will-zx/smart-greenhouse-dashboard/docs/kontrol.png

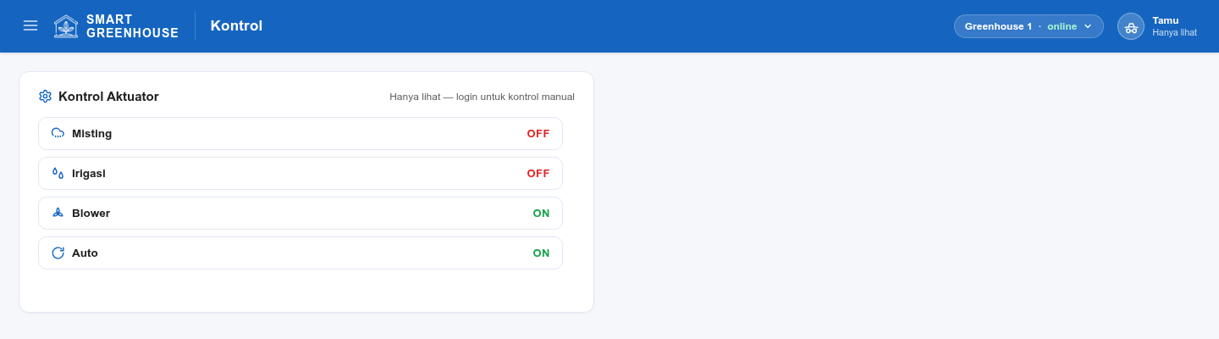
docs/kontrol.png
