will-zx/smart-greenhouse-dashboard/web/greenhouse.png

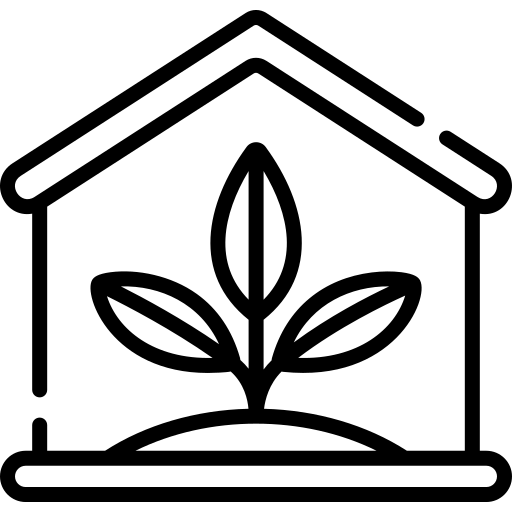
web/greenhouse.png
