will-zx/smart-greenhouse-dashboard/firmware/src/config.h

#ifndef CONFIG_H
#define CONFIG_H

#include "secrets.h"

// WiFi timeout (ms) + jeda percobaan reconnect berikutnya
#define WIFI_TIMEOUT    8000 // ponytail: shorter Wi‑Fi timeout to avoid long AP‑fallback stalls (ceiling: keep >5000 ms for stable reconnect)
#define WIFI_RETRY_MS   10000

// Firebase Realtime Database (Spark gratis, tanpa kartu kredit).
// DEVICE_ID & kredensial akun perangkat ada di secrets.h (satu per unit).
#define FIREBASE_DB_URL       "https://smart-greenhouse-e214c-default-rtdb.asia-southeast1.firebasedatabase.app"
#define LOGS_PATH             "/zones/" DEVICE_ID "/sensor_logs"
#define DB_PUSH_MS            20000
#define DB_POLL_MS            5000

// ID token Firebase berlaku 1 jam; re-login lebih awal agar tidak expired
// di tengah push. 55 menit = 5 menit margin.
#define TOKEN_REFRESH_MS      3300000

// Sensor: SHT31 (I2C, akurasi ±0.2°C / ±2% RH) — share bus dengan LCD.
// Alamat default 0x44 (LCD backpack PCF8574 di 0x27). Modul SHT31 umumnya sudah ada pull-up I2C.
#define SHT31_I2C_ADDR  0x44

// Tiga probe soil (kapasitif) supaya satu zona terwakili beberapa titik tanam.
// WAJIB di ADC1: selama WiFi aktif, ADC2 (GPIO 0,2,4,12-15,25-27) tidak bisa
// dipakai. Pemakaian ADC1 sekarang: 34/33/39 = soil, 35 = TDS, 32 = PUMP_DIST.
// 36 (VP) sengaja dikosongkan sebagai cadangan. 36/39 input-only tanpa
// pull-up - aman untuk keluaran analog modul ini.
#define SOIL_COUNT      3
#define SOIL_PINS       {34, 33, 39}

// I2C bus bersama: SHT31 + LCD 20x4 (backpack PCF8574 0x27; 0x3F = cadangan).
#define I2C_SDA         21
#define I2C_SCL         22
#define LCD_ADDR        0x27
#define LCD_COLS        20
#define LCD_ROWS        4

// Aktuator via modul XY-MOS 400W (umumnya AKTIF-HIGH: HIGH = ON).
// Kalau modul Anda aktif-LOW, set MOSFET_INVERTED 1 (di setActuators).
// Blower: 2 kipas 12x12cm DIPARALEL pada satu output PWM (LEDC).
#define MOSFET_MIST     26
#define BLOWER_PIN      25
#define BLOWER_FREQ     1000   // XY-MOS: spesifikasi PWM 0-20 kHz (25 kHz mati <100%); 1 kHz teruji
#define BLOWER_RES      8
// Duty minimum blower yang benar-benar memutar kipas (hw_test Okt 2026: start
// ~20 %, stop ~13 %). Level fuzzy di bawah ini dibulatkan naik ke nilai ini
// supaya perintah 0 < level < min tidak memerintahkan kipas yang diam.
#define BLOWER_MIN_DUTY 0.20f
#define MOSFET_INVERTED 0

// Pompa irigasi. Prototipe sekarang memakai SATU pompa: DIST (12V) menarik
// air langsung dari penampungan utama ke zona tanam.
// Fertigasi aktif kembali: FILL mengisi ember campuran, FERT menyalakan pompa
// stok A dan B, DIST mengalirkan larutan yang sudah diperiksa ke tanaman.
// Semua via modul XY-MOS/MOSFET (hormati MOSFET_INVERTED).
#define PUMP_FILL          13   // 12V: penampungan utama -> ember campuran
#define PUMP_FERT_A        14   // 5V : pupuk A -> ember
#define PUMP_FERT_B        15   // 5V : pupuk B -> ember
#define PUMP_DIST          32   // 12V: ember campuran -> tanaman

// ==== Durasi tiap fase fertigasi ====
// SEMUA ANGKA DI BAWAH INI BELUM DIUKUR. Masih perkiraan dan ditandai TODO
// supaya tidak tertukar dengan nilai hasil kalibrasi di atas.
// Cara ukur:
//  1) IRRIG_FILL_MS  = volume ember (mL) / debit FILL (31,7 mL/s) x 1000.
//  2) IRRIG_FERT_MS  = dosis yang diminta resep AB Mix / debit FERT (22,2 mL/s).
//  3) IRRIG_SETTLE_MS = jeda sampai pembacaan TDS berhenti bergerak.
// Isi 4,5 L dari ember 5 L: sisakan headroom untuk sisa air/debit pompa yang
// lebih tinggi. Ini bukan pengganti float switch; pasang cutoff overflow untuk
// perlindungan penuh. (4500 mL / 31,7 mL/s x 1000)
#define IRRIG_FILL_MS      141955
#define IRRIG_FERT_MS      1126    // 25 mL stok / 22,2 mL/s x 1000 = ~1,1 detik (TODO: sesuaikan via fase CHECK sampai TDS 800-1000 ppm)
#define IRRIG_SETTLE_MS    30000   // TODO: ukur lapangan - jeda sampai pembacaan TDS berhenti bergerak
// Jeda singkat di fase CHECK supaya pembacaan TDS stabil sebelum dinilai.
// SETTLE sudah memberi 30 detik tanpa pompa, jadi ini hanya jeda tambahan
// satu putaran loop controlTask (2 detik).
#define IRRIG_CHECK_MS      2000
// Batas waktu mutlak tiap fase supaya tidak ada pompa yang berjalan tanpa henti
// bila sensor atau waktunya nyangkut.
#define IRRIG_PHASE_TIMEOUT_MS 180000UL

// ==== Kalibrasi dosis irigasi (TERUKUR 21 Okt 2026) ====
// Debit pompa: gelas ukur + stopwatch, 3x, rata-rata.
//   pompa DIST (dan FILL) = 31,7 mL/s ; pompa FERT = 22,2 mL/s (tidak dipakai
//   lagi selama fertigasi ditunda, dicatat untuk mengaktifkan kembali).
// Cara ukur ulang: letakkan gelas ukur di outlet pompa, nyalakan pompa,
// catat volume setelah 30 s, ulangi 3x, ambil rata-rata -> mL/detik.
#define PUMP_DIST_ML_PER_S   31.7f
#define PUMP_FERT_ML_PER_S   22.2f
// Luas wetted zona: 10 polybag 30x30 cm, 2 baris -> 900 cm2 per tanaman
// (asumsi: permukaan atas polibag = area wetted), total 9000 cm2.
// Cara ukur ulang: hitung luas dasar tiap polybag (pi * d^2 / 4 dengan d =
// diameter polybag) x jumlah polybag.
#define IRRIG_AREA_CM2       9000.0f
// Jumlah siklus irigasi per hari. Dosis per siklus = anggaran harian / nilai
// ini, jeda minimum antar siklus = 24 jam / nilai ini.
// Cara tetapkan: dari kebutuhan harian (ETc x area) dan debit pompa -> bagi
// jadi beberapa dosis kecil supaya tidak ada siram besar sekaligus.
#define IRRIG_CYCLES_PER_DAY 2
// Gate irigasi otomatis: 1 = keputusan fuzzy boleh menyalakan pompa.
// 0 = irigasi otomatis dimatikan (siklus manual tetap bisa); dipakai sebelum
// debit & luas media tersedia. Badge status " IRIGOFF" muncul saat 0.
#define IRRIG_AUTO_ENABLED   1
// Catatan: asumsi efisiensi irigasi 1,0 (volume keluar pompa = volume sampai
// media), jadi TIDAK ada konstanta efisiensi terpisah.

// MicroSD (SPI, pin default VSPI ESP32: SCK 18, MISO 19, MOSI 23, CS 5).
// Backup lokal: seluruh log + antrian saat push Firebase gagal.
#define SD_CS           5
#define SD_BACKLOG_MAX  100
#define SD_BACKLOG_FLUSH_PER_CALL 20
// Tulis ulang seluruh file backlog setiap flush wears kartu SD.
// Push tiap 20s, jadi flush cukup 1x per 5 menit.
#define SD_FLUSH_MS     300000
#define SD_LOG_FLUSH_EVERY  30

// Timing (SHT31 jauh lebih cepat dari DHT22; delay(2000) di loop dipertahankan
// agar push DB & LCD tetap stabil).
#define LCD_INTERVAL    1000

// Baris status LCD (baris 4) di-scroll kalau lebih dari 20 kolom, karena
// controlTask cuma refresh tiap 2 s (terlalu lambat untuk marquee) sehingga
// geseran dikerjakan task kecil sendiri. 350 ms/karakter = ~7 s per putaran
// 20 kolom; ukur dengan mata di jarak baca ~1 m: kalau terasa cepat naikkan,
// kalau lambat turunkan.
#define LCD_SCROLL_MS       350
// Jeda di awal dan akhir teks supaya sempat terbaca sebelum mulai bergeser.
#define LCD_SCROLL_HOLD_MS  1500
// Prioritas di bawah netTask (2) dan controlTask (3): scroll tidak boleh
// menyalip kontrol aktuator. Core 0 (tempat netTask) supaya core 1 tetap
// khusus kontrol.
#define LCD_SCROLL_PRIO     1
#define LCD_SCROLL_STACK    3072   // Wire + LiquidCrystal_I2C + snprintf

// PSU cadangan: hardware-only — ESP32 + aktuator bisa ditenagai powerbank/PSU
// kedua saat listrik mati. Tidak ada kode khusus; dokumentasi di Laporan.

// ==== Blaney-Criddle: kebutuhan air ====
// Sumber: FAO Irrigation and Drainage Paper 24, "Crop Water Requirements",
// bab 1.1 (hal. 3), persamaan ETo = c * [ p * (0.46T + 8) ], dan Table 1
// "Mean Daily Percentage (p) of Annual Daytime Hours for Different Latitudes"
// (hal. 6). Berkas: 02/FAO Crop Water Requirement.pdf.
//
// Cara pakai p DIVALIDASI dari contoh terbuka Kairo pada halaman yang sama:
// lintang 30 derajat Utara bulan Juli, T = 28.5 C -> p = 0.31 -> p(0.46T+8)
// = 6.5 mm/hari. Artinya p dipakai LANGSUNG sebagai pecahan tabel (0.31),
// BUKAN sebagai persen (31) dan BUKAN sebagai hasil tafsir rumus (N/24).
//
// Nilai p tabel FAO-24 berada di kisaran 0.23-0.41 untuk lintang 0-60, dan
// mendekati 0.27 pada lintang rendah. Angka 0.48 yang dipakai sebelumnya
// berasal dari tafsir rumus (N/24) di atas, bukan dari tabel -> ETo melebih
// sekitar 65 persen, dan karena ETc langsung menentukan dosis pompa,
// kelebihan itu ikut terkirim ke tanaman.
//
// Faktor penyesuaian c (bergantung pada RHmin, n/N, dan angin siang) TIDAK
// dipakai di sini (c = 1). FAO-24 meminta metode ini dipakai dengan skeptis
// pada daerah khatulistiwa yang suhunya nyaris konstan, dan Penman-Monteith
// (FAO-56) tetap metode standar. Hasil di sini karena itu dilabeli
// pendekatan, bukan ETo standar.
//
// p per bulan untuk lintang Semarang (6 derajat 58 LS, dibulatkan 7 LS).
// Tabel FAO-24 hanya memuat lintang 0, 5, 10, ... sehingga nilai berikut
// DIHASILKAN DENGAN INTERPOLASI LINIER antara baris 5 dan 10, memakai
// ketentuan catatan kaki tabel: "Southern latitudes: apply 6 month
// difference" (bulan Selatan memakai kolom Utara yang digeser 6 bulan).
// Baris mentah 5 LS dan 10 LS hanya berselisih 0.01, jadi galat
// interpolasinya kecil.
// TODO: PERIKSA ULANG ke Table 1 sebelum dikutip di laporan, karena ini
// hasil interpolasi, bukan bacaan langsung.
static const float SUN_P_MONTH[12] = {
    0.284f, // Januari
    0.280f, // Februari
    0.280f, // Maret
    0.270f, // April
    0.266f, // Mei
    0.266f, // Juni
    0.266f, // Juli
    0.270f, // Agustus
    0.270f, // September
    0.280f, // Oktober
    0.280f, // November
    0.284f  // Desember
};
// Konstanta rumus Blaney-Criddle: ETo = p * (BC_T_COEF * Tmean + BC_T_CONST).
#define BC_T_COEF        0.46f
#define BC_T_CONST       8.0f
// Tmean = rata-rata suhu sliding 3 jam (ember 1 menit). FAO-56 menetapkan
// Penman-Monteith sebagai metode standar; Blaney-Criddle (FAO-24) dikalibrasi
// untuk periode panjang, jadi hasil di sini PENDEKATAN PRAKTIS (bukan ETo
// standar) dan harus diberi label begitu di log maupun telemetri.
#define BC_TMEAN_BUCKET_MS   60000UL   // 1 menit per ember
#define BC_TMEAN_BUCKETS     180      // 180 ember x 1 menit = 3 jam sliding
// Batas atas ETo (mm/hari) supaya nilai ekstrem tidak dipakai.
#define MAX_ET0        12.0

// Kc per fase pertumbuhan. Sumber: Tabel 2.1 proposal ("Nilai koefisien
// tanaman (Kc) pada tanaman cabai merah", data Supriadi et al. [10]):
// Awal 0,40 | Vegetatif 0,75 | Pembungaan 1,10 | Pemuliaan buah 1,00 | Panen 0,90
// Default = fase "Vegetatif" -> perilaku lama (Kc 0,75) tetap berlaku.
#define KC_AWAL           0.40f
#define KC_VEGETATIF      0.75f
#define KC_PEMBUNGAAN     1.10f
#define KC_PEMULIAAN_BUAH 1.00f
#define KC_PANEN          0.90f
#define KC_DEFAULT        KC_VEGETATIF

// Soil Moisture Calibration (modul KAPASITIF, inverted ADC: kering=tinggi, basah=rendah).
// Urutan array = urutan SOIL_PINS: {34, 33, 39}.
// Kalibrasi PER PROBE: dua modul model sama bisa beda ratusan count, jadi satu
// angka untuk semuanya membuat persentase salah. Cara ukur (~10 menit):
//   1) probe di udara kering, tunggu ~3 menit, baca "raw" pada baris Soil:n
//   2) probe terendam penuh di air, baca lagi
//   3) isi SOIL_DRY_CAL = bacaan kering, SOIL_WET_CAL = bacaan basah
//      (kering selalu > basah karena ADC terbalik; kalau tidak, kabel tertukar)
// ponytail: angka awal masih asumsi v1.2 (2644/1200); ukur ulang per probe.
#define SOIL_DRY_CAL    {2644, 2644, 2644}
#define SOIL_WET_CAL    {1200, 1200, 1200}
// Toleransi raw ADC di luar titik kalibrasi. Probe dicabut -> ADC mengambang
// (0 atau 4095) -> di luar rentang ini -> ditandai tidak valid (bukan 100 %
// basah / 0 % kering palsu). Angka ini hanya "jaring pengaman", bukan kalibrasi.
#define SOIL_RAW_TOL 300
// Sampel per kanal. Sampel pertama DIBUANG (bukan dirata-rata) karena ADC
// ESP32 masih membawa sisa muatan kanal sebelumnya; kapasitif berimpedansi
// tinggi sehingga satu bacaan pertama sering meleset jauh.
#define SOIL_SAMPLES   4
// Jeda antar kanal. Kalau angka tiga probe terlihat saling "menular" (mis. probe
// 33 mengikuti nilai 34), naikkan ini; kelipatan 10 ms murah di loop 2 s.
#define SOIL_SETTLE_MS 10

// TDS Meter v1.0 (analog, klon DFRobot SEN0244) di ember campuran irigasi.
// Output ~0..2.3V. GPIO35 = ADC input-only tanpa pull-up. Kompensasi suhu
// memakai suhu SHT31. Kalibrasi: TDS_CAL_K (set dengan larutan standar).
// CATATAN: TDS dipakai sebagai PEMERIKSA setelah larutan homogen, bukan
// pengendali dosis. Dosis stok A/B berjalan selama IRRIG_FERT_MS (lingkaran
// terbuka) menurut debit pompa yang sudah terukur, sehingga konsentrasi
// diharapkan jatuh di dalam rentang. TDS memverifikasi dugaan itu.
//
// PERILAKU SAAT DI LUAR RENTANG: kalau TDS TERBACA sah dan di luar rentang,
// DIST DITAHAN (siklus dibatalkan, anggaran harian dikembalikan) karena kimia
// larutannya jelas salah. Kalau probe TIDAK terbaca (tdsValid=false), air
// tetap dialirkan dengan peringatan - tanpa probe tanaman tidak akan pernah
// disiram. Lihat fase IRRIG_CHECK di irrigation.cpp.
#define TDS_PIN         35
#define TDS_ADC_MAX     4095.0
#define TDS_REF_VOLT    3.3
#define TDS_TARGET_PPM  1000.0  // konsentrasi larutan akhir (air penampungan ~400 ppm)
#define TDS_CAL_K       1.0
// Rentang penerimaan larutan sebelum distribusi.
// TODO: perkiraan belaka. Tetapkan dari resep AB Mix yang benar-benar dipakai:
//   ppm_target = dosis stok (mL) / volume ember (mL) x konsentrasi stok (ppm)
// Lalu ukur dengan larutan standar dan sesuaikan TDS_CAL_K.
#define TDS_MIN_PPM     800.0f
#define TDS_MAX_PPM    1200.0f
// Rentang raw ADC yang dianggap sah (probe terendam, bukan mengambang / dicabut)
// dan rentang ppm. Di luar itu TDS ditandai tidak valid -> dosis pupuk tidak
// dihitung dari angka garbage.
#define TDS_RAW_MIN     200
#define TDS_RAW_MAX     3000
#define TDS_PPM_MIN     50.0f
#define TDS_PPM_MAX     5000.0f
// Ambang stabilitas antar 8 sampel TDS. Pin GPIO35 (ADC input-only, tanpa
// pull-up/pull-down) melayang saat probe dicabut -> nilai tengah tak stabil
// yang lolos cek rentang [TDS_RAW_MIN, TDS_RAW_MAX] dan menghasilkan PPM palsu.
// Kalau spread terlalu besar, angka dianggap tidak andal -> valid = false.
#define TDS_FLOAT_SPREAD 300.0f

// Filter EMA (Exponential Moving Average): y[n] = alpha*x[n] + (1-alpha)*y[n-1].
// alpha kecil = lebih halus tapi lebih lambat. Dipakai untuk suhu & kelembaban
// (input VPD) serta soil, agar VPD dan keputusan irigasi tidak bergetar.
// Alfa di sini PER-SAMPEL, bukan per-detik: konstanta waktunya t = dt/alfa.
// Loop controlTask 2000 ms dengan alfa 0.2 -> t = 10 s (63% perubahan dalam
// 10 s). Kalau periode loop diubah, alfa harus diskalakan ulang: alfa = dt/(t+dt).
#define EMA_ALPHA_TEMP  0.2f
#define EMA_ALPHA_HUM   0.2f
#define EMA_ALPHA_SOIL  0.2f
// TDS paling bising (pompa fert berdenyut 2 s on / 1 s off, jadi dua iterasi
// berurutan bisa menangkap kondisi adukan berbeda). Difilter lebih cepat dari
// suhu/kelembapan supaya gate target TDS tidak bereaksi pada satu sampel.
#define EMA_ALPHA_TDS   0.3f

// Kontrol VPD berbasis setpoint fase (di-set admin dari dashboard). Setpoint
// ini KOREKSI terhadap keluaran fuzzy, bukan pengganti: fuzzy tetap menentukan
// apa yang dijalankan, setpoint hanya mendorong satu arah.
// VPD > target+BAND -> tambah/pertahankan misting (blower tetap sesuai fuzzy).
// VPD < target-BAND -> dorong blower proporsional (misting tetap sesuai fuzzy).
// Di dalam band -> fuzzy menentukan sepenuhnya.
#define VPD_BAND_KPA    0.2f
// Duty maksimum yang boleh ditambahkan setpoint ke blower. Setpoint tidak
// pernah menaikkan blower ke penuh mendadak; duty penuh hanya bila fuzzy
// juga memintanya.
#define VPD_BOOST_MAX   0.6f
// Rentang VPD target yang diterima dari dashboard (kPa). Di luar ini perintah
// ditolak di sisi device (VPD wajar hortikultura: 0,3-2,5 kPa).
#define VPD_TARGET_MIN  0.3f
#define VPD_TARGET_MAX  2.5f


// Setelan fase default (dipakai bila NVS masih kosong). Admin dapat mengubah
// nama fase, VPD target, dan durasi dari dashboard; tersimpan di NVS.
#define PHASE_DEFAULT_VPD       1.0f       // kPa
#define PHASE_DEFAULT_NAME      "Vegetatif"
#define PHASE_DEFAULT_DURATION  0u         // detik; 0 = tanpa batas
#define NVS_NAMESPACE           "smartgh"

// Batas durasi override manual (ms). Setelah lewat, aktuator yang di-override
// otomatis kembali ke kendali fuzzy — misting tidak boleh menyala semalaman.
#define MANUAL_MAX_MS           600000UL   // 10 menit

// Timeout Task WDT (detik) + inisialisasi eksplisit (lihat RumahHijau.ino).
#define WDT_TIMEOUT_S           5

// Cooldown perintah restart (ms) supaya reboot berulang tidak memutus
// siklus irigasi.
#define RESTART_COOLDOWN_MS     60000UL

// Durasi fase maksimum (detik) = 365 hari, biar tidak overflow uint32.
#define PHASE_MAX_DURATION_SEC  31536000UL

#endif
