will-zx/smart-greenhouse-dashboard/(commit log)

2026-09-09 Inisialisasi project: firmware ESP32 + web dashboard Firebase
2026-09-13 UI: toggle switch aktuator & Auto, ikon rumah, ekspos manual_mode ke RTDB
2026-09-13 Auth: sesi per-tab (SESSION) — tutup tab = login ulang
2026-09-30 REV.1 + multi-zone: SHT31/MOSFET/MicroSD, hapus Telegram, path zones/{id}
    Hardware & kontrol:
    - Sensor DHT22 -> SHT31 (I2C 0x44, share bus dengan OLED)
    - Relay active-LOW -> modul MOSFET 15A/400W aktif-HIGH (knob MOSFET_INVERTED)
    - Blower on/off -> PWM LEDC 25kHz, duty = fuzzy.blowerLevel
    - Telegram bot dihapus (kanal kontrol hanya dashboard); alert suhu ekstrem ke serial
    - sd_logger: CSV lokal tiap bacaan + antrean backlog saat push RTDB gagal
    - Irigasi jadi single source of truth di irrigation.shouldIrrigate
    - Fuzzy pakai VPD (cabai): vpdHigh dorong misting, vpdLow suppress mist + blower
    Multi-zone (greenhouse-in-greenhouse):
    - DEVICE_ID pindah ke secrets.h (satu per unit, tidak di-commit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
2026-09-30 Dashboard: multi-zone, label greenhouse, penyembunyian kontrol untuk viewer
    - ZONES[] di config.js ganti DEVICE_ID; satu dashboard untuk banyak unit
    - Selector zona di header + device id aktif; fetch per zona terpilih
    - Badge online per zona dari umur log (>60s = 'diam N menit')
    - Label greenhouse: labels/{DEVICE_ID} di RTDB, admin ubah lewat tombol pensil
    - applyRole(): sembunyikan card kontrol + tombol label, badge 'Mode lihat' untuk non-admin
    - app.js?v=9 -> ?v=11 (cache-buster Cloudflare)
2026-09-30 .gitignore: plugin OpenCode lokal + backup rules RTDB
    .rules_rtdb.bak = jaring pengaman sebelum publish rules, jangan masuk repo
    (plugin .opencode/ sudah di-version-control, tapi plugins/ state per mesin)
2026-09-30 Keluarkan AGENTS.md & opencode.json dari repo
    --cached: file tetap ada di disk, hanya lepas dari index.
    AGENTS.md = instrucciones lokal tim; opencode.json = state per mesin.
    .gitignore tetap di repo supaya proteksi secrets.h ikut ke clone baru.
2026-10-08 Irigasi 4 pompa + sensor TDS: siklus FILL-FERT-DIST, keputusan irigasi pindah ke fuzzy Mamdani (soil x ETc)
2026-10-11 Firmware RTOS 2-task: controlTask (core 1) + netTask (core 0), snapshot bermutex
    - I/O jaringan (TLS handshake, WiFi join s/d 15s) tidak lagi menahan jalur
    aktuator; pulse pompa FERT 2s/1s tidak korup saat push gagal/reconnect.
    - controlTask: sensor -> VPD/ETc -> fuzzy -> override -> aktuator -> state
    machine irigasi -> LCD -> log SD -> publish snapshot (periode 2s).
    - netTask: WiFi join/reconnect, NTP, token, push 20s, poll perintah 5s,
    backlog MicroSD. loop() tinggal idle.
    - Mutex: state manual (control.cpp), akses SD dua task (sd_logger.cpp);
    sdFlushBacklog lepas kunci saat HTTP supaya tidak menahan controlTask.
2026-10-11 Dashboard: switch/Auto sinkron dari perangkat + umpan balik seketika saat klik
    - fetchDataLogs() tidak pernah memanggil updateActuatorStates(): posisi switch
    dan toggle Auto tak pernah tersinkron di mode live (state hanya disimpulkan
    dari entri sensor_logs terbaru; tidak ada node state di RTDB).
    - applyLocalCommand(): perintah sukses langsung memperbarui tampilan, jadi Auto
    mati begitu switch aktuator diklik, tanpa menunggu push 20 s (DRY: dipakai
    jalur live dan demo).
    - optimistic (35 s = poll 5 s + push 20 s + fetch 10 s): menahan tampilan sampai
    log yang mencerminkan perintah tiba, supaya switch tidak balik sendiri.
    - cache-buster app.js?v=12.
2026-10-11 Firmware: filter EMA sensor + kontrol VPD setpoint fase
    - filter.{h,cpp}: EMA (alpha dari config.h) untuk suhu, RH (input VPD), soil
    - phase.{h,cpp}: VPD target + nama fase + durasi, disimpan di NVS
    - kontrol override: VPD > target+band -> MISTING, < target-band -> BLOWER
    - pollCommands: set_vpd / set_fase / set_durasi / fase_reset
    - pushSensorLog: telemetri fase (vpd_target, fase_elapsed_s, fase_sisa_s)
2026-10-12 Firmware: fail-safe sensor mati + task WDT untuk controlTask
    Dua celah yang bisa menyisakan pompa/misting nyala tanpa kendali:
    1. Nilai fuzzy beku saat sensor invalid. `fuzzyOut` hanya ditulis di dalam
    `if (sensorData.valid)`, tapi dibaca tanpa syarat di bawahnya. SHT31
    putus -> mist/blower/irigasi tetap memakai keputusan iterasi valid
    terakhir, selamanya, dan misting/irigasi tidak punya timeout sendiri.
    Sekarang semua aktuator dipatikan saat `!valid` (override manual ikut)
    dan siklus irigasi berjalan dibatalkan via irrigationAbort().
    Status jadi "Sensor Error" (bukan "Normal" basi) supaya operator dan
    pill dashboard ikut tahu regulate sudah berhenti.
    2. controlTask bi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
2026-10-12 Dashboard: ikon header pakai greenhouse.png
    SVG inline di h1 diganti asset greenhouse.png (512x512, garis hitam
    dengan alpha transparan tanpa latar putih).
    Warna lewat CSS mask, bukan filter invert: mask memberi #90caf9 yang sama
    dengan ikon svg lama (lewat background-color), sedangkan invert() hanya
    menghasilkan putih dan akan terlihat berbeda dari ikon lain di header.
    Aturan .header h1 svg ikut dihapus karena h1 tidak lagi memuat svg.
    Verified: semua piksel di luar garis punya alpha 0 dan tidak ada piksel
    putih opaque, jadi tidak muncul kotak putih pada header biru tua._aturan
    svg lain (.badge, .card-head, .ctrl, .metric, .refresh) tidak tersentuh.
2026-10-12 Dashboard: fix ikon header (elemen kosong, 28px, putih) + cache-busting
    Ikon tetap hitam meski mask sudah aktif. Penyebabnya: mask berlaku ke
    seluruh rendering elemen, dan konten <img> bersifat opaque sehingga
    menutupi background-color di belakangnya. Warnanya tidak pernah terlihat.
    Mask hanya bisa mengecat elemen KOSONG -> <img> diganti <span>.
    Ukuran 22 -> 28 px (garis PNG ~2% dari 512 px, di 22 px只剩 1 px).
    Warna #90caf9 -> #fff, mengikuti teks header.
    style.css dimuat tanpa versi (?v=) sehingga browser menyajikan CSS lama
    dari cache dan perbaikan tidak terlihat. Sekarang ?v=13,_seperti app.js?v=12.
    aria-hidden="true" pada span: ikon dekoratif, tanpa itu screen reader
    membacakan nam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
2026-10-12 Dashboard: ET0 jadi subskrip di label metrik (flex mengabaikan vertical-align)
2026-10-12 Dashboard: bungkus ET0 dalam span agar subskrip di label metrik benar
2026-10-12 Dashboard: hapus tooltip email di avatar, email tetap di menu akun
2026-10-12 Dashboard: migrasi layout admin (sidebar + topbar) sesuai referensi; satu skema warna; burger toggle sidebar di desktop & drawer di mobile
2026-10-13 Dashboard: tombol pensil rename per unit, hover user chip tanpa tabrakan teks, sinkron switch/teks ON-OFF, Refresh berputar, tag nama greenhouse di grafik
2026-10-13 Dashboard: perbaiki nama unit yang tak terlihat (warna putih di kartu putih), tag + Refresh juga di halaman Log
2026-10-13 Dashboard: gabungkan pemilih greenhouse + status koneksi, ganti prompt() dengan input inline, perbaiki tidak bisa ganti unit di handphone
2026-10-13 Dashboard: status unit tetap terlihat di ponsel, ikon ikut mewarnai status, kartu kontrol ikut konten
2026-10-13 README: ganti diagram alur ASCII dengan mermaid (baca & tulis via RTDB, task ESP32 terpisah)
2026-10-13 Firmware: arsipkan firmware_old, hapus kode mati, satukan setter kontrol
    Audit over-engineering repo (laporannya di /sdcard/ponytail-audit.txt).
    11 dari 13 temuan diterapkan; item 2 (modul fase) dan 3 (antrean backlog
    SD) ditunda karena butuh keputusan pemilik perangkat.
    - hapus firmware_old/ (25 file, -1046): arsip pra-FreeRTOS yang sudah ada
    di git history (c8be90e)
    - control: controlSetMist/Irig/Blower -> controlSet(bit, on) dengan
    bitmask uint8_t; 3 setter identik jadi satu fungsi
    - fuzzy: 3 blok loop identik -> helper evalRules() + tipe Rule
    - vpd.h/.cpp -> calcVpd() statis di RumahHijau.ino
    - hapus kode mati: emaReset(), phaseElapsed(), FuzzyOutput::irigasiLevel
    Verifikasi: fuzzy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
2026-10-13 Dashboard: hapus halaman Kontrol & sidebar, kontrol menyatu di Beranda
    Satu halaman dengan dua blok: 6 metrik (2 kolom x 3 baris) di kiri,
    kartu Kontrol Aktuator di sebelahnya, grafik tren penuh di bawah.
    Di ponsel semuanya satu kolom: metrik -> kontrol -> grafik.
    - hapus <section id="view-kontrol">; 4 sakelar pindah ke kartu kontrol
    (id state-*/sw-* dipertahankan, updateActuatorStates & onSwitch
    tidak berubah)
    - hapus sidebar + burger + drawer; navigasi cukup tombol Log Sensor
    di topbar yang toggle Beranda <-> Log Sensor (state baru: currentView)
    - topbar: brand pindah ke kiri, teks posisi halaman dihapus
    - kartu grafik: judul + tag unit + Refresh satu baris di kanan,
    keterangan "D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
2026-10-13 Dashboard: kembalikan teks branding di ponsel, buang garis pemisah brand
    Aturan `.brand-text { display: none }` di bawah 700px adalah warisan waktu
    brand masih di sidebar (248px). Setelah sidebar dihapus brand tinggal di
    topbar yang sempit, jadi teksnya tidak lagi boleh disembunyikan - yang
    tersisa cuma ikon, garis pemisah yang menggantung, dan ruang kosong.
    - <=700px: teks brand kembali (11px, dua baris seperti desain aslinya),
    ikon 28 -> 24px, gap 10 -> 8px
    - yang boleh dipotong bukan branding tapi status unit: .zone-status
    flex 0 0 auto -> 0 1 auto + min-width:0 (juga di .topbar-actions dan
    .zone-btn), jadi pill "diam 2806 mnt" yang menyusut lebih dulu di
    layar sempit
    - .brand: h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
2026-10-13 Docs: refresh screenshot dashboard & log sensor sesuai layout baru
    - dashboard.png: metrik 2x3 di kiri, kartu Kontrol Aktuator (ikon gear)
    di sebelahnya dengan tepi bawah rata, grafik tren penuh di bawah;
    keterangan "Data terakhir ..." ada di bawah grafik, bukan di header
    - log-sensor.png: tombol topbar jadi "Beranda" (state terbalik saat Log
    terbuka) dan kartu log tanpa teks posisi halaman
    - kembalikan referensi docs/log-sensor.png di README; file itu sudah ada
    sejak commit f39fb64 tapi rujukan gambarnya hilang, jadi tidak pernah
    tampil di README
    Catatan (bukan bagian commit ini): urutan waktu di tabel log dan sumbu X
    grafik masih urut push-ID Firebase, bukan field ts - tampak di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
2026-10-14 Dashboard: perbaiki pembacaan log, rapikan durasi & warna status, revisi kartu grafik
    - apiRead(): token ditempel dengan '&' bila path sudah punya query string.
    Sebelumnya selalu '?auth=', jadi limitToLast jadi "20?auth=..." dan RTDB
    membalas 400 "limitToLast must be an integer". Tidak terdeteksi karena tamu
    tanpa token tidak pernah terpengaruh.
    - Durasi umur data dalam bahasa sehari-hari (detik/menit/jam/hari) lewat satu
    fungsi humanAge(); pakai floor, bukan round, supaya 23 jam 59 menit tidak
    melebar jadi "24 jam". Dipakai di bawah grafik dan di pill greenhouse.
    - Pill greenhouse: tidak menampilkan nama unit lagi, hanya kapan data terakhir
    masuk. Status ditandai warna isian (hi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
2026-10-14 Docs: segarkan screenshot & keterangan tampilan sesuai dashboard terbaru
    Screenshot diambil ulang dari tampilan tamu (tanpa login) pada lebar 1440 px
    dan 390 px. Tiga bagian README yang sudah tidak sesuai dengan kode:
    - status di tombol greenhouse kini warna isian (hijau = segar, kuning = basi
    kurang dari sehari, merah = basi lebih dari sehari atau gagal dibaca) dan isian
    tombolnyaumur data terakhir, bukan nama unit
    - nama greenhouse menyambung di judul kartu grafik, bukan chip terpisah
    - tabel log punya kolom waktu yang menempel di kiri saat digeser di ponsel
    Ditambah screenshot tampilan ponsel, karena tata letak satu kolomnya kini
    dijelaskan di README tanpa bukti gambar.
2026-10-14 Git: abaikan web/config.js (berisi API key & email admin)
    Baruatarsilan-box: .gitignore hanya berlaku untuk file yang belum pernah
    di-commit, jadi entri ini belum mengubah apa pun - web/config.js masih
    terlacak. Penghapusan dari indeks (git rm --cached) sengaja tidak dilakukan
    karena dashboard berjalan di worker dan mungkin menarik file dari repo.
    Yang benar-benar sensitif - firmware/src/secrets.h berisi password akun
    perangkat - memang tidak pernah masuk history sama sekali.
2026-10-14 Dashboard: urutkan log & grafik berdasarkan waktu, kontras pill hijau
    - Log sensor diurutkan berdasarkan field ts, bukan kunci push-ID RTDB.
    Kunci urut saat apa yang ditulis, tapi record lama yang diputar ulang
    dari backlog MicroSD dapat kunci baru - kunci jadi tidak sama dengan
    waktu. Akibatnya kolom waktu di tabel tidak urut (22.27.15 -> 22.26.45
    -> 22.27.35 -> 18.36.08) dan sumbu X grafik melompat. Sekarang
    Object.values + sort ts, satu baris lebih pendek dari versi lama.
    - Pill hijau #3f9c44 -> #2e7d32: rasio kontras teks putih 3.47:1 -> 5.13:1,
    melewati ambang WCAG AA 4.5:1 untuk teks kecil. Merah 4.75:1 dan kuning
    12.84:1 sudah memenuhi.
    - Koreksi komentar di blok 700px y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
2026-10-14 Firmware: filter EMA untuk TDS, koreksi cakupan filter soil
    TDS adalah kanal paling bising dan satu-satunya yang tidak difilter: yang
    ada cuma rata-rata 8 sampel dalam 80 ms di readTDS(), itu meredam noise ADC
    dalam satu iterasi saja. Pompa fert berdenyut 2 s on / 1 s off sementara
    loop controlTask membaca tiap 2 s, jadi dua iterasi berurutan menangkap
    kondisi adukan yang berbeda - terlihat di log TDS dashboard yang melompat
    0 -> 117 -> 23 -> 34 -> 0 -> 6 -> 144 ppm.
    - EmaFilter keempat untuk TDS (alfa 0.3, tau ~6.7 s). Gate target di
    irrigation.cpp memakai nilai terfilter ini sekarang.
    - irrigationPhase() sebagai accessor, dipakai me-reset filter TDS tiap
    siklus masuk fase FERT. Empiri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
2026-10-18 Firmware: bulatkan duty blower di bawah 20% ke duty minimum kipas
    Kipas hasil uji hw_test baru berputar pada duty ~20% dan berhenti di ~13%,
    sehingga level fuzzy 0 < level < 0,20 memerintahkan kipas yang diam. Level
    kini dinaikkan ke BLOWER_MIN_DUTY (config.h) sebelum dikirim ke LEDC, lalu
    dicetak sekali lewat Serial. fuzzy.cpp tidak diubah supaya lapisan
    keputusan tetap murni.
2026-10-18 Tools: simulasi logika fuzzy Octave + model .fis
    firmware/tools/fuzzy_sim.m adalah replika fuzzy.cpp (13 membership, 3 tabel
    rule, evalRules) dengan tabel kasus acuan yang di-assert, sehingga perubahan
    tabel rule di firmware langsung ketahuan. Menghasilkan grafik (butuh gnuplot,
    diabaikan lewat .gitignore) dan fuzzy_rules.fis untuk dibuka di MATLAB
    fuzzyLogicDesigner. Jalankan dari akar repo:
    octave --no-gui --eval "addpath('firmware/tools'); fuzzy_sim"
2026-10-19 Firmware: kirim keluaran fuzzy aktuator ke RTDB
    Tambahkan blower_level, misting, dan irigasi ke payload sensor_logs.
    Selama ini dashboard harus menguraikan string status_sistem untuk tahu
    aktuator mana yang hidup — rapuh, karena bergantung pada format teks.
2026-10-19 Web: migrasi dashboard ke Vue 3 + Vite + Tailwind
    Ganti file statis (index.html + app.js + style.css, 1533 baris) dengan
    proyek Vue 3 + Vite 8 + Tailwind 4. Semua 80 pemanggilan DOM manual
    (getElementById/innerHTML/classList) dan 5 handler inline hilang; logika
    sensor dipindah apa adanya ke satu reactive() di src/store.js.
    Perubahan:
    - 9 komponen .vue, CSS 533 -> 53 baris (@theme palet)
    - config.js pindah ke public/ (Vite menyalin apa adanya ke dist/)
    - ikon brand greenhouse.png jadi CSS mask, kembali seperti semula
    - layout metrik 2x3 + kolom kontrol proporsional 46% (seperti desain lama)
    Bug yang tertangkap saat migrasi:
    - popup unit kosong: const di config.js masuk global LEXICAL, bukan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
2026-10-19 Web: tambah wrangler.jsonc untuk Cloudflare Workers static assets
    Project ini Workers dengan static assets, bukan Pages klasik — dashboard
    menampilkan "Triggers cannot be added to a Worker that only has static
    assets" dan TIDAK punya field "build output directory". Folder hasil
    build ditentukan di file config, jadi wrangler.jsonc wajib ada;
    tanpa itu `wrangler deploy` tidak tahu mana yang harus di-upload.
    wrangler dijadikan devDependency karena deploy command memanggil
    `npx wrangler deploy`. Dry-run terverifikasi: 6 file terbaca dari dist/.
2026-10-19 Web: shorten Worker subdomain
    smart-greenhouse-dashboard.capstone-26.workers.dev (54 char) ->
    versi yang lebih pendek. Nama Worker di wrangler.jsonc WAJIB sama
    persis dengan yang ada di dashboard; kalau beda, `wrangler deploy`
    membuat Worker baru dan production tetap menyajikan versi lama.
2026-10-19 README: catat URL produksi yang aktif
    Dashboard live di smartgh.capstone-26.workers.dev (Cloudflare Workers
    dengan static assets). README sebelumnya tidak punya tautan sama sekali
    ke dashboard yang sedang jalan.
2026-10-21 Firmware: overhaul override manual, WDT, setpoint VPD, dan validasi sensor
    Bug P0 yang diperbaiki:
    - Override manual jadi TRIS-TATA per aktuator (-1 ikut fuzzy, 0 paksa mati,
    1 paksa nyala). Dulu satu bitmask mengatur SEMUA aktuator, jadi mematikan
    satu sakelar mematikan seluruh aktuator dan tidak ada jalan kembali
    selain Auto. Sekarang mematikan sakelar = aktuator itu kembali ke fuzzy;
    Auto (controlRelease) mengembalikan semua.
    - Task WDT di-init eksplisit di setup() (timeout 5 s, panic). Framework
    arduino-esp32 2.0.17 (ESP-IDF 4.4) tidak pernah memanggil
    esp_task_wdt_init() sendiri (CONFIG_ESP_TASK_WDT_INIT tidak ada di
    sdkconfig), jadi subscribe controlTask gagal diam-diam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
2026-10-21 Firmware: perbaiki edge-trigger irigasi, ETc Blaney-Criddle, status override
    G-1 (P0) Irigasi mati permanen setelah sensor error singkat. prevTrigger
    tadinya static di dalam irrigationUpdate() dan tidak pernah di-reset;
    irrigationAbort() (dipanggil dari luar) tidak melewatinya, jadi permintaan
    yang masih TRUE setelah pemulihan tidak pernah lagi memicu siklus.
    Sekarang prevTrigger jadi state modul, di-reset saat abort, dan ada flag
    resumePending supaya permintaan yang masih aktif langsung memulai siklus
    baru (log "siklus DIPULIHKAN"). Edge-detect tetap: satu permintaan = satu
    siklus. Log baru: siklus dimulai / dibatalkan / dipulihkan.
    G-2 (P0) Status override per aktuator dikirim ke RTDB: mi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
2026-10-21 Web: badge IRRIGOFF, koreksi komentar perintah, README sesuai UI sekarang
    - Badge IRRIGOFF di tabel log (warna peringatan, bukan merah) + banner amber di
    kartu Kontrol: irigasi otomatis sengaja dimatikan perangkat sampai debit
    pompa dikalibrasi, perintah manual tetap jalan. Banner juga tampil untuk tamu.
    - Koreksi komentar blok "perintah RTDB": bentuk lama (POST {action,value} ke
    commands/{DEVICE_ID}) sebenarnya juga terbaca firmware, karena POST di REST
    Firebase setara push() sehingga objek itu berakhir sebagai anak ber-push-ID.
    Entri tetap ditulis sebagai anak dengan kunci eksplisit supaya urutannya
    jelas; kode pengiriman tidak diubah.
    - parseOverride sekarang mengenali string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
2026-10-21 Docs: perbarui screenshot dashboard ke UI Vue yang sedang produksi
    Tiga screenshot diambil ulang dari produksi (https://smartgh.capstone-26.workers.dev/)
    dalam mode Tamu, setelah deploy bundle baru:
    - docs/dashboard.png (1440x1083) - Beranda: metrik (ETc), kartu Kontrol Aktuator
    tanpa sakelar admin, panel Fase & Setpoint VPD, grafik tren.
    - docs/log-sensor.png (1440x1200) - Log Sensor: 20 baris terbaru, kolom ETc,
    tombol Export CSV, catatan retensi.
    - docs/mobile.png (390x1372, skala 2) - tampilan ponsel.
    Data di RTDB terakhir berasal dari perangkat yang push 11 Okt, jadi pill kesegaran
    dan keterangan "Data terakhir ..." sengaja masih merah/basi.
2026-10-21 Docs: ukuran screenshot dashboard sesuai permintaan (1440x900, 390x844 @2x)
    dalam mode Tamu, ukuran persis seperti dokumenasi sebelumnya:
    - docs/dashboard.png (1440x900) - Beranda: metrik (ETc), Kontrol Aktuator tanpa
    sakelar admin, Panel Fase & Setpoint VPD, grafik tren dengan garis terisi.
    - docs/log-sensor.png (1440x900) - Log Sensor: 20 baris terbaru, kolom ETc,
    tombol Export CSV.
    - docs/mobile.png (390x844, skala 2) - tampilan ponsel.
    Data RTDB terakhir berasal dari perangkat yang push 11 Okt, jadi pill kesegaran
    dan keterangan "Data terakhir ..." masih merah/basi - memang kondisi nyata.
    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
2026-10-21 Firmware: irigasi satu pompa DIST dengan dosis dari ETc (Blaney-Criddle)
    Prototipe sekarang memakai SATU pompa (DIST) yang menarik air langsung dari
    penampungan utama; fase FILL (isi ember) dan FERT (dosis pupuk) dibuang.
    PUMP_FILL/PUMP_FERT_A/PUMP_FERT_B tetap ada di config.h dan tetap dipaksa
    LOW di initActuators(): firmware tidak pernah memanggilnya.
    Irigasi (irrigation.cpp)
    - State machine IDLE -> DIST -> IDLE; penggerak pompa cuma setDist().
    - Dosis air per siklus dihitung dari ETc yang sudah ada (Tmean sliding 3 jam
    x Kc fase):
    anggaran_harian_ml = ETc * IRRIG_AREA_CM2 * 0,1
    dosis_ml = anggaran_harian_ml / IRRIG_CYCLES_PER_DAY
    durasi_pompa_ms = dosis_ml / PU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
2026-10-21 Web: rapikan jarak kartu grafik, longgarkan CSP untuk koneksi Firebase
    Jarak antara kartu "Fase & Setpoint VPD" dan "Grafik Tren Sensor" kelihatan
    jauh lebih besar daripada jarak antar kartu lain, di desktop maupun ponsel.
    Penyebabnya TrendChart.vue punya mt-5 di root-nya, sementara section di
    App.vue sudah memberi gap-5 untuk semua anak. mt-5 itu sisa layout lama
    saat grafik menempel langsung di baris metrik; setelah Panel Fase
    disisipkan, margin itu menumpuk jadi jarak dobel hanya di kartu ini.
    TrendChart satu-satunya komponen yang punya margin di root-nya - dihapus
    supaya ritme jarak seragam di semua tampilan.
    CSP: connect-src ditambah www.gstatic.com, *.nstatic.com, dan
    wss://*.firebase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
2026-10-21 Docs: perbarui screenshot dashboard setelah perbaikan jarak kartu
    Layout berubah karena mt-5 pada kartu Grafik Tren Sensor dihapus, jadi
    capture lama tidak lagi mencerminkan tampilan produksi. Ukuran tetap sama
    seperti sebelumnya: 1440x900 untuk desktop dan 390x844 @2x untuk ponsel.
    Screenshot Log Sensor tidak berubah karena tampilan log tidak terpengaruh.
2026-10-25 Firmware: perbaiki Tmean selalu NaN (ETc 0, irigasi tidak pernah jalan)
    Ditemukan saat uji di device setelah flash: serial menampilkan
    "Tmean:nan ETc:0.0mm" terus-menerus, padahal SHT31 terbaca valid.
    Akar masalah: tmeanBucket[] adalah array static sehingga terisi 0,0, bukan
    NaN, sedangkan sentinel "ember kosong" di irrigationFeedTemp() adalah NaN.
    Akibatnya isnan() tidak pernah true -> tmeanValid tidak pernah bertambah ->
    irrigationTmean() selalu mengembalikan NaN -> calculateEtc() = 0 -> dosis 0
    dan irigasi tidak pernah jalan. Bug masuk bersama Tmean sliding window
    (commit 625b13d) dan tidak tertangkap simulasi karena simulasi tidak
    mereplikasi jendela Tmean.
    Perbaikan: isi array dengan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
2026-10-25 Firmware: jangan eksekusi ulang perintah RTDB yang sama
    Ditemukan setelah device tersambung ke RTDB: satu perintah dieksekusi ulang
    tiap poll 5 s (blower dipaksa nyala terus, irigasi berulang). Penyebabnya
    aturan RTDB: /commands/$zone hanya boleh DITULIS admin, device hanya boleh
    baca, jadi DELETE dari device selalu ditolak 401 dan entri tidak pernah
    hilang. Node commands/{DEVICE_ID} sudah berisi 65 entri lama.
    Perbaikan (tidak mengubah aturan RTDB):
    - Penanda perintah terakhir yang sudah dieksekusi disimpan di NVS
    (last_cmd). Push-ID Firebase terurut leksikografis, jadi key <= last_cmd
    dianggap sudah dijalankan dan dilewati. Bertahan walau reboot.
    - Entri yang bukan objek perintah dile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
2026-10-25 Web: grafik air (VPD + kebutuhan/pemakaian) dan rentang 6 jam/24 jam
    - TrendChart: prop mode ('iklim' default, perilaku lama; 'air' memuat VPD
    kiri 0-4 kPa, target VPD putus-putus, kebutuhan harian dari ETc pada
    sumbu kanan mL, dan volume terpakai hari ini sebagai garis stepped).
    Tooltip air menyebut ETc penyusun anggaran dan kata "hari ini", karena
    irigasi_terpakai_ml reset tiap 00:00 WIB.
    - App: kartu Grafik Air tepat di bawah kartu iklim, memakai gap yang ada.
    - store: TREND_RANGE 6 jam (1080 record, bucket 5 menit, poll 2 menit) dan
    24 jam (4320 record, bucket 10 menit, poll 15 menit). Down-sample di
    store: rata-rata temperature/humidity/vpd/etc/vpd_target/anggaran, dan
    nil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
2026-10-25 Firmware: kembalikan lapisan fertigasi (enam fase), p Blaney-Criddle dari tabel FAO-24
    Siklus irigasi berubah dari DIST tunggal menjadi FILL -> FERT -> SETTLE ->
    CHECK -> DIST. Empat pompa (FILL 13, FERT_A 14, FERT_B 15, DIST 32)
    digerakkan lewat setPumps() yang selalu menulis keempatnya sekaligus, jadi
    tidak pernah ada keadaan separuh (satu nyala, yang lain belum dimatikan).
    Dosis larutan tetap memakai hitungan yang sudah ada: ETc x 9000 cm2 x 0,1
    dibagi IRRIG_CYCLES_PER_DAY, dijadikan durasi pompa DIST lewat debit terukur
    31,7 mL/s. FERT berjalan LINGKARAN TERBUKA: durasinya tetap, dari debit FERT
    terukur 22,2 mL/s dan resep AB Mix, tidak disesuaikan terhadap bacaan TDS.
    TDS karena itu h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
2026-10-25 Docs: README sesuai siklus irigasi enam fase dan tabel p FAO-24
    - Tabel aktuator: FILL/FERT A/FERT B tidak lagi berlabel "tidak dipakai".
    - Debit FERT 22,2 mL/s dicatat bersama DIST 31,7 mL/s, dengan catatan
    durasi fase FILL/FERT/SETTLE masih perkiraan dan ditandai TODO.
    - Bagian "Siklus irigasi" ditulis ulang jadi tabel enam fase, termasuk
    penjelasan bahwa TDS hanya memverifikasi dan tidak menahan air.
    - Bagian ETc menulis p sebagai 0,266-0,284 per bulan (tabel FAO-24) alih-
    alih 0,48, beserta asal angka lamanya.
2026-10-25 fix: perbarui durasi fase fertigasi berdasarkan perhitungan volume ember 5L
    IRRIG_FILL_MS: 30000 -> 157728 ms (5000 mL / 31,7 mL/s)
    IRRIG_FERT_MS: 45000 -> 1126 ms (25 mL stok / 22,2 mL/s, resep 5-5-1)
    IRRIG_SETTLE_MS: 30000 ms dipertahankan, perlu pengukuran lapangan
    Semua angka masih ditandai TODO untuk verifikasi di lapangan.
2026-10-25 tds: tandai probe tidak terpasang sebagai invalid agar PPM palsu tidak muncul
    GPIO35 (TDS) adalah ADC input-only tanpa pull-up/pull-down, sehingga saat
    probe dicabut ADC melayang. Nilai tengah yang lolos rentang [TDS_RAW_MIN,
    TDS_RAW_MAX] sebelumnya tetap menghasilkan PPM berarti (valid=true).
    Tambahkan deteksi spread antar 8 sampel: bila rentang bervariasi lebih dari
    TDS_FLOAT_SPREAD, angka dianggap tidak andal -> valid=false, sehingga
    telemetri menampilkan NAN ('-') dan status TDSERR.
2026-10-25 Firmware: TDS menahan distribusi, pompa dinyalakan saat fase dimasuki
    Fase CHECK sebelumnya hanya memberi peringatan, jadi larutan di luar
    800..1200 ppm tetap dialirkan ke tanaman. Sekarang:
    - TDS terbaca sah dan di luar rentang -> DIST DITAHAN, siklus dibatalkan,
    anggaran harian dikembalikan (air tidak pernah sampai ke tanaman);
    - probe tidak terbaca (tdsValid=false) -> air tetap dialirkan dengan
    peringatan, karena tanpa probe tanaman tidak akan pernah disiram;
    - alasan tahan TDS dipertahankan sampai siklus berikutnya, supaya tidak
    tertimpa pesan "jeda minimum belum lewat" dua detik kemudian dan tetap
    terbaca operator di dashboard.
    Pompa sekarang dinyalakan saat fase DIMASUK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
2026-10-25 Firmware: tiga probe soil di ADC1 (34/33/39) dan telemetri soil2/soil3
    Satu probe tidak cukup mewakili beberapa titik tanam, jadi ditambah dua probe
    kapasitif. Semua di ADC1 karena ADC2 (GPIO 0,2,4,12-15,25-27) tidak bisa
    dipakai selama WiFi aktif. Pemetaan: 34 = probe 1, 33 = probe 2, 39 (VN) =
    probe 3, 36 (VP) dikosongkan. TDS tetap 35, PUMP_DIST tetap 32.
    Pembacaan per probe: 4 sampel dengan sampel pertama dibuang (ADC ESP32 masih
    membawa sisa muatan kanal sebelumnya, modul kapasitif berimpedansi tinggi) dan
    jeda SOIL_SETTLE_MS antar kanal. Validitas tetap memakai SOIL_RAW_TOL, tapi
    sekarang per kanal: probe yang dicabut/di luar rentang tidak lagi menarik
    rata-rata, sehingga dua probe te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
2026-10-25 Firmware: status_sistem jadi label aksi, bukan kata kondisi + nama aktuator
    "Warning MISTING BLOWER" tidak enak dibaca dan tidak memberi tahu apa yang
    sedang dilakukan alat: kata "Warning" itu menilai udara (suhu/RH), sedangkan
    MISTING/BLOWER menempel sebagai sufiks tanpa hubungan kalimat.
    buildStatus() sekarang menyusun label dari aktuator yang benar-benar jalan,
    urut prioritas irigasi -> misting -> blower, digabung dengan " + " dan satu
    "ON" di ujung: "Irigasi ON", "Misting ON", "Misting + Blower ON". Kalau tidak
    ada aktuator nyala, dipakai kata kondisi fuzzy apa adanya (Normal/Monitor/
    Warning/Kritis) supaya penilaian udara tidak hilang dan fuzzy.cpp tidak jadi
    kode mati. "Sensor Error"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
2026-10-25 Firmware: baris status LCD digeser task sendiri, bus I2C dikunci mutex
    controlTask cuma refresh LCD tiap 2 s (vTaskDelayUntil 2000 ms), jadi status
    yang lebih dari 20 kolom bukan cuma kepotong - marquee di dalam task itu akan
    bergerak 1 karakter per 2 detik, tidak terbaca. Karena itu baris 4 diserahkan
    ke task kecil sendiri (core 0, prio 1, di bawah netTask dan controlTask):
    teks <= 20 kolom ditulis statis, lebih dari itu digeser 350 ms/karakter dengan
    jeda 1,5 s di awal dan akhir supaya sempat dibaca. Baris hanya ditulis ulang
    kalau isinya berubah, supaya teks pendek/jeda tahan tidak membanjiri bus I2C
    (~57 tulis/detik). Task ini sengaja tidak subscribe Task WDT - kalau macet,
    hanya baris s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
2026-10-25 Web: kartu kelembapan tanah per probe dan peringatan siklus ditahan
    - SoilCard (baru): soil sebagai angka utama (nilai dari perangkat, tidak
    dihitung ulang di client) plus rincian "probe 1/2/3" yang hanya muncul
    untuk probe yang datanya ada. Record lama tanpa soil2/soil3 tidak
    menampilkan baris kosong atau 0.
    - TrendChart mode iklim: seri Soil 2 dan Soil 3 berbagi sumbu kanan dengan
    kelembapan (semua persen), jadi tetap dua sumbu Y. Data yang tidak ada
    dibiarkan null -> Chart.js menggambar celah.
    - Controls: irigasi_alasan_tahan tampil sebagai banner peringatan kuning
    sendiri (siklus dibatalkan, air tidak dialirkan), tidak lagi sebagai teks
    kecil di dalam baris telemetri. Progr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
2026-10-25 Firmware: telemetri status probe tanah dan mode paksa mati aktuator
    Dua hal yang sama-sama dibutuhkan dashboard tetapi tidak bisa ditebak dari
    sisi klien.
    Status probe tanah: soil2/soil3 dibuang dari JSON saat probe gagal (putNum
    melewati NaN), jadi "probe tercabut" tidak bisa dibedakan dari "record
    firmware lama". Sekarang soil_ok (bitmask, bit0 = probe 1) dan soil_n (jumlah
    probe valid) selalu dikirim, termasuk saat semuanya mati. Serial mencetak satu
    baris hanya ketika bitmask berubah, jadi kabel yang lepas/tersambung lagi
    terlihat di log tanpa membanjiri tiap 2 detik.
    Mode paksa mati: sakelar dashboard dulu hanya bisa mengirim true/false, dan
    false selalu berarti "kembali ke fuzzy" - a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
2026-10-25 Web: satu nilai tanah, grafik tren satu kartu, sakelar bisa paksa mati
    Kartu tanah: satu angka saja. Keputusan irigasi memakai rata-rata tiga probe,
    jadi angka per probe di dashboard tidak menambah informasi - yang perlu
    terlihat adalah apakah semua probe masih terbaca. soil_n dari perangkat
    ditampilkan sebagai "3/3 probe" / "n/3 probe" / "probe tidak terdeteksi".
    SoilCard beserta grafik tanahnya dihapus, saneSoil() (jendela 5-95 %) ikut
    dibuang karena menyembunyikan bacaan ekstrem yang sah; nilai sekarang apa
    adanya, null tetap "-".
    Grafik: kartu iklim dan kartu air digabung jadi satu grafik tiga sumbu -
    suhu, kelembapan, dan VPD (hijau, sumbu kanan kedua). Target VPD tidak
    digambar karena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
2026-10-25 Docs: README menyusul tiga commit terakhir
    - Warna pill topbar: krem memakai token peringatan yang sama dengan pill di
    tabel log, bukan kuning menyala - hue jenuh bertabrakan dengan biru topbar
    dan teksnya sulit dibaca. Alasannya ditulis supaya tidak dikembalikan.
    - Beranda: enam metrik dasar ditambah dua kartu air (Dosis harian + sisa
    anggaran, Air terpakai) yang hanya muncul bila perangkat mengirim field
    irigasi. Kartu Tanah satu angka (rata-rata probe yang dipakai fuzzy) plus
    status probe n/3, karena angka per probe tidak menambah informasi operator.
    Grafik jadi satu kartu tiga sumbu dengan rentang 6/24 jam; target VPD dan
    grafik tanah/air terpisah dihapus.
    - Sakelar: knob =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
2026-10-30 Shorten Wi‑Fi timeout to 8 s; add Wi‑Fi manager module; keep DB push interval at 20 s.
2026-10-30 Implement full PEAP‑MSCHAPv2 support, non‑blocking AP fallback, credential list & delete, prevent duplicate/overflow, update docs.
2026-10-30 Simpan epoch mulai fase di NVS agar elapsed/remaining tidak reset setelah power loss.
2026-10-30 Perbaiki umur data saat jam perangkat belum sinkron
    Record tanpa ts dulu diurutkan paling akhir, jadi selalu dipakai sebagai data
    terakhir dan pill topbar bertahan "jam belum sinkron" walau device sudah
    mengirim record berts.
    - clockTrusted(): ts ada dan time_synced tidak false.
    - lastData = record tepercaya terbaru, fallback ke record terakhir menurut
    urutan key bila belum ada satu pun yang tepercaya.
    - Sort menaruh record tanpa ts di depan (paling tua), bukan di belakang.
    - age hanya dihitung untuk record tepercaya, di-clamp minimal 0.
    - trendData membuang record tanpa ts, jadi tidak ada titik "?" di ujung
    grafik.
    - checkPending memakai record terakhir menurut key supaya konfirmasi pe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
